bgamari/lamp/board/v1/setpoint-design.ods

Sheet: Sheet1
Vsense | V | Vout | R11 | R9 | R12
0.8 | 0 | 3.63781818181818 | 8.20E+03 | 1.00E+04 | 2.20E+03
0.8 | 0.1 | 3.55581818181818 | 2.20E+04 | 5.00E+04 | 4.70E+03
0.8 | 0.2 | 3.47381818181818 | 8.20E+03 | 1.00E+04 | 2.20E+03
0.8 | 0.3 | 3.39181818181818
0.8 | 0.4 | 3.30981818181818
0.8 | 0.5 | 3.22781818181818
0.8 | 0.6 | 3.14581818181818
0.8 | 0.7 | 3.06381818181818
0.8 | 0.8 | 2.98181818181818
0.8 | 0.9 | 2.89981818181818
0.8 | 1 | 2.81781818181818
0.8 | 1.1 | 2.73581818181818
0.8 | 1.2 | 2.65381818181818
0.8 | 1.3 | 2.57181818181818
0.8 | 1.4 | 2.48981818181818
0.8 | 1.5 | 2.40781818181818
0.8 | 1.6 | 2.32581818181818
0.8 | 1.7 | 2.24381818181818
0.8 | 1.8 | 2.16181818181818
0.8 | 1.9 | 2.07981818181818
0.8 | 2 | 1.99781818181818
0.8 | 2.1 | 1.91581818181818
0.8 | 2.2 | 1.83381818181818
0.8 | 2.3 | 1.75181818181818
0.8 | 2.4 | 1.66981818181818
0.8 | 2.5 | 1.58781818181818
0.8 | 2.6 | 1.50581818181818
0.8 | 2.7 | 1.42381818181818
0.8 | 2.8 | 1.34181818181818
0.8 | 2.9 | 1.25981818181818
0.8 | 3 | 1.17781818181818
0.8 | 3.1 | 1.09581818181818
0.8 | 3.2 | 1.01381818181818
0.8 | 3.3 | 0.931818181818182
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
