bgamari/lamp/board/v2/lamp.kicad_pcb

## KiCad design board/v2/lamp.kicad_pcb (2021-12-30)

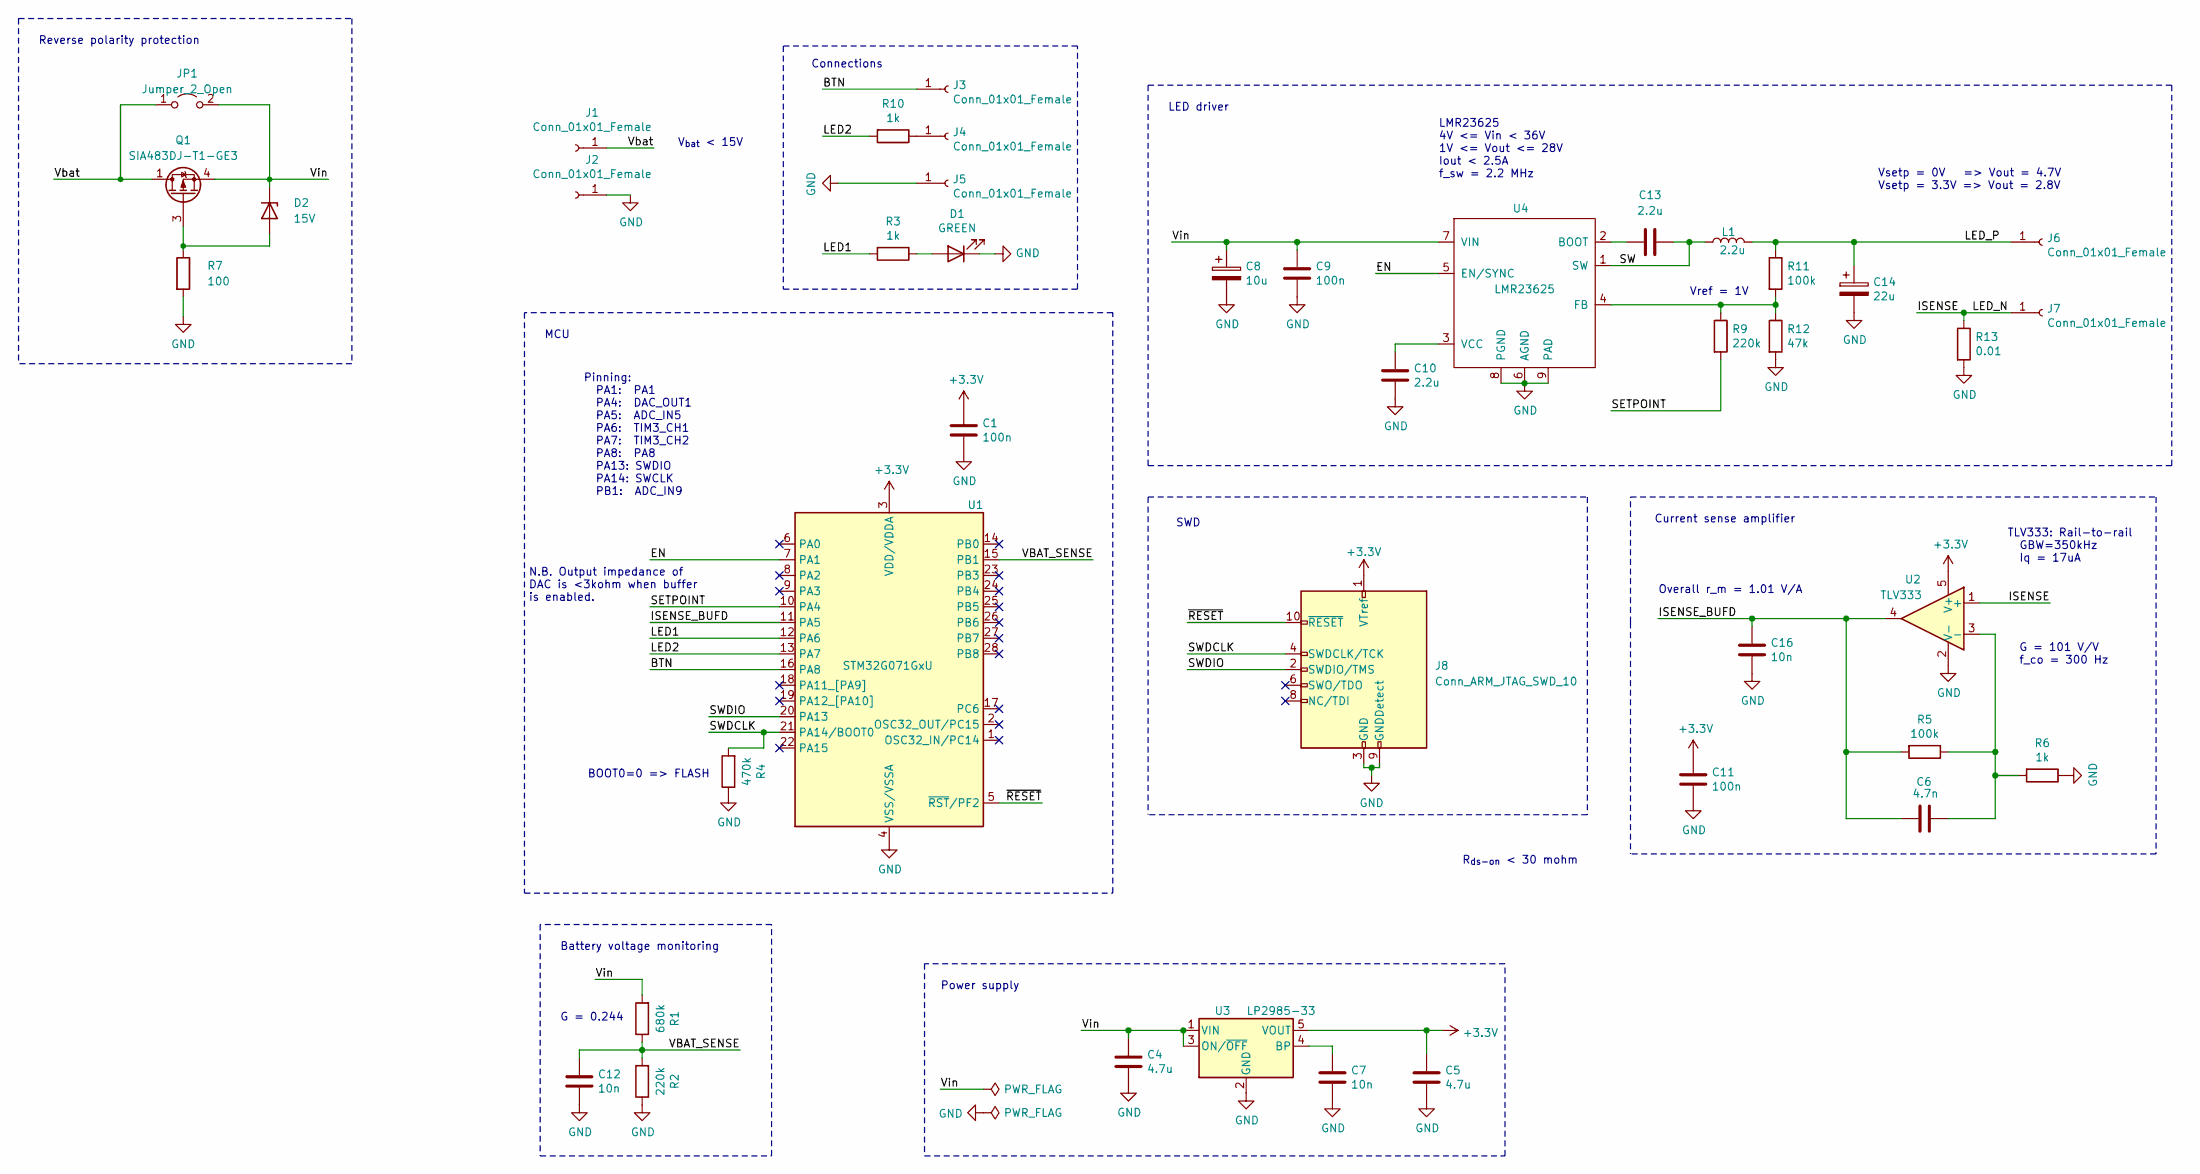
[picture p1: schematic lamp.kicad_sch, LED driver]

Parts:
C1, C9, C11: 100n; C_0603_1608Metric
C4: 4.7u; C_0805_2012Metric_Pad1.18x1.45mm_HandSolder
C5: 4.7u; C_0603_1608Metric
C6: 4.7n; C_0603_1608Metric
C7, C12, C16: 10n; C_0603_1608Metric
C8: 10u; CP_EIA-3528-12_Kemet-T; MPN T520B106M016ATE100
C10, C13: 2.2u; C_0603_1608Metric
C14: 22u; CP_EIA-7343-15_Kemet-W; MPN 25TQC22MV
D1: GREEN; LED_0603_1608Metric
D2: 15V; D_SOD-123
J1, J2, J3, J4, J5, J6, J7: Conn_01x01_Female; SolderWirePad_1x01_Drill1mm
J8: Conn_ARM_JTAG_SWD_10; PinHeader_2x05_P1.27mm_Vertical_SMD; MPN 3221-10-0300-00
JP1: Jumper_2_Open; SolderJumper-2_P1.3mm_Open_RoundedPad1.0x1.5mm
L1: 2.2u; L_7.3x7.3_H4.5; MPN DR74-2R2-R
Q1: SIA483DJ-T1-GE3‎; Vishay_PowerPAK_SC70-6L_Single; MPN SIA483DJ-T1-GE3‎
R1: 680k; R_0603_1608Metric
R2, R9: 220k; R_0603_1608Metric
R3, R6, R10: 1k; R_0603_1608Metric
R4: 470k; R_0603_1608Metric
R5, R11: 100k; R_0603_1608Metric
R7: 100; R_0603_1608Metric
R12: 47k; R_0603_1608Metric
R13: 0.01; R_0805_2012Metric; MPN RL1220T-R010-J
U1: STM32G071GxU; QFN-28_4.3x4.3_Pitch0.5mm
U2: TLV333; SOT-353_SC-70-5_Handsoldering
U3: LP2985-33; SOT-23-5; MPN LP2985-33DBVR
U4: LMR23625; SOIC-8-1EP_3.9x4.9mm_P1.27mm_EP2.29x3mm_ThermalVias; MPN TLV62130

Connections:
+3V3: C1.1, C5.1, C11.1, J8.1 (VTref), U1.3 (VDD/VDDA), U2.5 (V+), U3.5 (VOUT)
/BTN: J3.1, U1.16 (PA8)
/EN: U1.7 (PA1), U4.5 (EN/SYNC)
/ISENSE: J7.1, R13.1, U2.1 (+)
/ISENSE_BUFD: C6.2, C16.1, R5.2, U1.11 (PA5), U2.4
/LED1: R3.2, U1.12 (PA6)
/LED2: R10.2, U1.13 (PA7)
/LED_P: C14.1, J6.1, L1.2, R11.1
/SETPOINT: R9.2, U1.10 (PA4)
/SW: C13.2, L1.1, U4.1 (SW)
/SWDCLK: J8.4 (SWDCLK/TCK), R4.2, U1.21 (PA14/BOOT0)
/SWDIO: J8.2 (SWDIO/TMS), U1.20 (PA13)
/VBAT_SENSE: C12.1, R1.1, R2.2, U1.15 (PB1)
/Vbat: J1.1, JP1.1 (A), Q1.1 (D)
/Vin: C4.1, C8.1, C9.1, D2.1 (K), JP1.2 (B), Q1.4 (S), R1.2, U3.1 (VIN), U3.3 (ON/~OFF), U4.7 (VIN)
/~RESET: J8.10 (~RESET), U1.5 (~RST/PF2)
GND: C1.2, C4.2, C5.2, C7.2, C8.2, C9.2, C10.2, C11.2, C12.2, C14.2, C16.2, D1.1 (K), J2.1, J5.1, J8.3 (GND), J8.5 (GND), J8.9 (GNDDetect), R2.1, R4.1, R6.1, R7.2, R12.2, R13.2, U1.4 (VSS/VSSA), U2.2 (V-), U3.2 (GND), U4.6 (AGND), U4.8 (PGND), U4.9 (PAD)
unnamed: C6.1, R5.1, R6.2, U2.3 (-)
unnamed: C7.1, U3.4 (BP)
unnamed: C10.1, U4.3 (VCC)
unnamed: C13.1, U4.2 (BOOT)
unnamed: D1.2 (A), R3.1
unnamed: D2.2 (A), Q1.3 (G), R7.1
unnamed: J4.1, R10.1
unnamed: R9.1, R11.2, R12.1, U4.4 (FB)

Notes on the sheet:
Reverse polarity protection
N.B. Output impedance of DAC is <3kohm when buffer is enabled.
MCU
Battery voltage monitoring
G = 0.244
Pinning: PA1: PA1 PA4: DAC_OUT1 PA5: ADC_IN5 PA6: TIM3_CH1 PA7: TIM3_CH2 PA8: PA8 PA13: SWDIO PA14: SWCLK PB1: ADC_IN9
BOOT0=0 => FLASH
V_{bat} < 15V
Connections
Power supply
LED driver
SWD
LMR23625 4V <= Vin < 36V 1V <= Vout <= 28V Iout < 2.5A f_sw = 2.2 MHz
R_{ds-on} < 30 mohm
Current sense amplifier
Overall r_m = 1.01 V/A
Vref = 1V
Vsetp = 0V => Vout = 4.7V Vsetp = 3.3V => Vout = 2.8V
TLV333: Rail-to-rail GBW=350kHz Iq = 17uA
G = 101 V/V f_co = 300 Hz

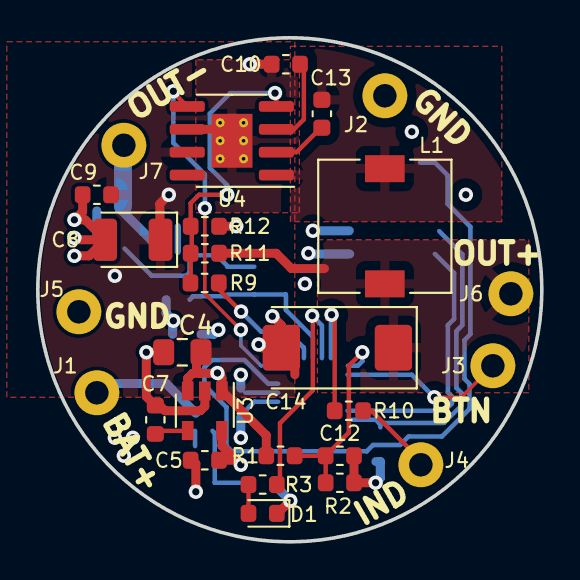
[picture p2: board board/v2/lamp.kicad_pcb from above]

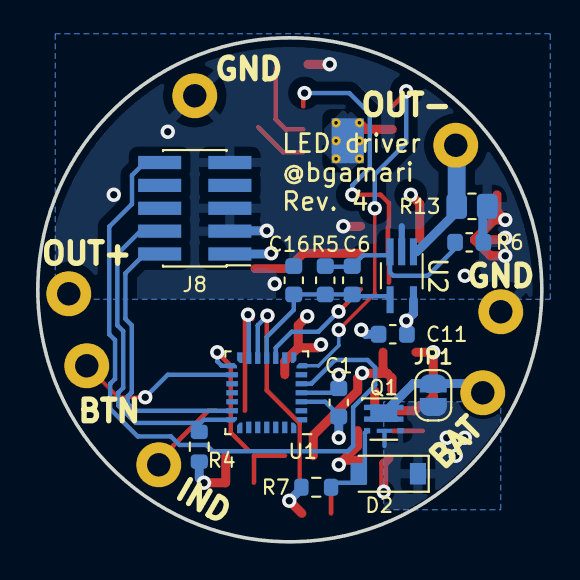
[picture p3: board board/v2/lamp.kicad_pcb from below]

Board: 4 copper layers, 28.0 x 28.0 mm, 42 parts (15 on the bottom side), 25 nets.
