bgamari/lamp/board/v1/lamp.kicad_pcb

## KiCad design board/v1/lamp.kicad_pcb (2018-07-23, an earlier design)

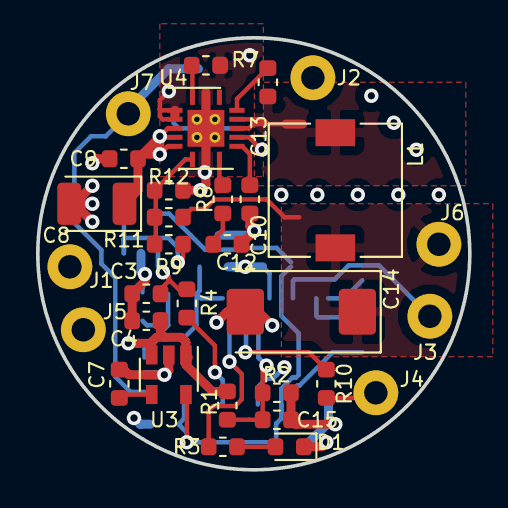
[picture p4: board board/v1/lamp.kicad_pcb from above]

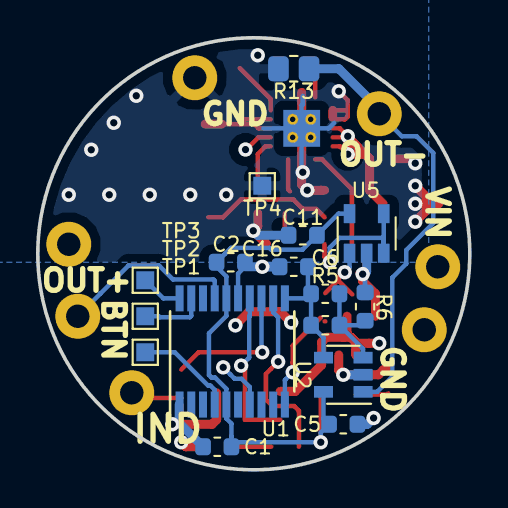
[picture p5: board board/v1/lamp.kicad_pcb from below]

Board: 4 copper layers, 24.0 x 24.0 mm, 47 parts (16 on the bottom side), 28 nets.

Parts:
C1, C2, C4, C5, C6, C7, C9, C11, C13: 100n; C_0603_1608Metric
C3: 1u; C_0603_1608Metric
C8: 10u; CP_EIA-3528-12_Kemet-T
C10, C15, C16: 10n; C_0603_1608Metric
C12: 22n; C_0603_1608Metric
C14: 47u; CP_EIA-7343-15_Kemet-W
D1: LED; LED_0603_1608Metric
J1, J2, J3, J4, J5, J6, J7: Conn_01x01_Female; SolderWirePad_1x01_Drill1mm
L1: 4.7u; L_7.3x7.3_H4.5
R1: 47k; R_0603_1608Metric
R2, R4: 10k; R_0603_1608Metric
R3, R6, R8, R10: 1k; R_0603_1608Metric
R5: 100k; R_0603_1608Metric
R7: 40k; R_0603_1608Metric
R9: 50k; R_0603_1608Metric
R11: 22k; R_0603_1608Metric
R12: 4.7k; R_0603_1608Metric
R13: 0.01; R_0805_2012Metric
TP1, TP2, TP3, TP4: Test_Point; TestPoint_Pad_1.0x1.0mm
U1: STM32F030F4P6; TSSOP-20_4.4x6.5mm_P0.65mm
U2, U5: LMV321; SOT-23-5
U3: MIC5205-3.3; SOT-23-5
U4: TPS54620; Texas_S-PVQFN-N14_ThermalVias

Connections:
+3V3: C1.1, C2.1, C5.1, C11.1, U1.5, U1.16, U2.5, U3.5, U5.5
/BTN: J3.1, U1.17
/EN: U1.7, U4.10
/ISENSE: J7.1, R13.1, U2.1
/LED1: R3.2, U1.12
/LED2: R10.2, U1.13
/LED_P: C14.1, J6.1, L1.2, R11.1
/SETPOINT: C3.1, R4.1, U5.1
/SW: C13.1, L1.1, U4.11, U4.12
/SWCLK: TP3.1, U1.20
/SWDIO: TP2.1, U1.19
/VBAT: C15.1, R1.1, R2.2, U1.14
/VIN: C4.1, C8.1, C9.1, J1.1, R1.2, U3.1, U3.3, U4.4, U4.5, U4.6
GND: C1.2, C2.2, C3.2, C4.2, C5.2, C7.2, C8.2, C9.2, C10.2, C11.2, C12.1, C14.2, C15.2, C16.2, D1.1, J2.1, J5.1, R2.1, R6.1, R7.2, R12.2, R13.2, TP4.1, U1.1, U1.15, U2.2, U3.2, U4.2, U4.3, U4.15, U5.2
unnamed: C6.1, R5.1, R6.2, U2.3
unnamed: C7.1, U3.4
unnamed: C10.1, U4.9
unnamed: C12.2, R8.2
unnamed: C13.2, U4.13
unnamed: C6.2, C16.1, R5.2, U1.11, U2.4
unnamed: D1.2, R3.1
unnamed: J4.1, R10.1
unnamed: R4.2, U1.10
unnamed: R7.1, U4.1
unnamed: R8.1, U4.8
unnamed: R9.2, U5.3, U5.4
unnamed: R9.1, R11.2, R12.1, U4.7
unnamed: TP1.1, U1.4
