bgamari/lamp/board/v1/performance.ods

Device | Vin | Iin | Vout | Iout | Pin | Pout | Efficiency | Setpoint | Comments
C | 4.85 | 0.63 | 3.42 | 0.74 | 3.0555 | 2.5308 | 82.83%
C | 5.11 | 0.146 | 2.82 | 0.23 | 0.74606 | 0.6486 | 86.94%
C | 5.07 | 0.221 | 2.94 | 0.33 | 1.12047 | 0.9702 | 86.59%
C | 5.02 | 0.314 | 3.07 | 0.422 | 1.57628 | 1.29554 | 82.19%
C | 4.96 | 0.433 | 3.2 | 0.545 | 2.14768 | 1.744 | 81.20%
C | 4.91 | 0.525 | 3.3 | 0.635 | 2.57775 | 2.0955 | 81.29%
C | 4.81 | 0.708 | 3.47 | 0.778 | 3.40548 | 2.69966 | 79.27%
C | 5.18 | 0.017 | 0.596 | 0.075 | 0.08806 | 0.0447 | 50.76% |  | No emissions
B | 5.12 | 0.165 | 2.85 | 0.26 | 0.8448 | 0.741 | 87.71%
B | 5.09 | 0.243 | 2.97 | 0.36 | 1.23687 | 1.0692 | 86.44%
B | 5.05 | 0.33 | 3.08 | 0.454 | 1.6665 | 1.39832 | 83.91%
B | 5 | 0.431 | 3.18 | 0.565 | 2.155 | 1.7967 | 83.37%
B | 4.96 | 0.53 | 3.29 | 0.664 | 2.6288 | 2.18456 | 83.10%
B | 4.91 | 0.626 | 3.38 | 0.748 | 3.07366 | 2.52824 | 82.26%
B | 4.89 | 0.69 | 3.42 | 0.803 | 3.3741 | 2.74626 | 81.39%
B | 5.19 | 0.017 | 0.586 | 0.06 | 0.08823 | 0.03516 | 39.85%
A | 5.19 | 0.016 | 0.586 | 0.048 | 0.08304 | 0.028128 | 33.87%
A | 5.07 | 0.29 | 3.06 | 0.412 | 1.4703 | 1.26072 | 85.75%
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
