bgamari/lamp/(commit log)

2018-06-30 Move to four layers, value selection
    [lamp.kicad_pcb, lamp.sch]
2018-06-30 More iteration
    [lamp.kicad_pcb, lamp.sch]
2018-06-30 Make LED PWMable
    [lamp.kicad_pcb, lamp.sch]
2018-06-30 Make other LED PWMable
    [lamp.kicad_pcb, lamp.sch]
2018-07-02 Use timers that are available on all parts
    [lamp.kicad_pcb, lamp.sch]
2018-07-22 firmware: Button support
2018-07-22 Move PWM class out to new source file
2018-07-23 More or less working
    [lamp.kicad_pcb, lamp.sch]
2019-07-03 Fix component values
    [lamp.sch]
2019-07-03 Move board design to board/v1
    [lamp.kicad_pcb, lamp.sch, performance.ods, setpoint-design.ods]
2019-07-03 v2 hardware
    [lamp.kicad_pcb, lamp.sch]
2019-07-12 hardware: Various fixes
    * Fix component values
    * Replace MIC5202 which wasn't ceramic-stable
    [lamp.kicad_pcb, lamp.sch]
2019-07-18 board/v2: Various design changes
    * Switch from MIC5202 to LP2985 due to ceramic stability issues
    with former
    * Use TLV333 for op-amps for reduced power and offset
    * Move current sense amplifier next to sense resistor
    [lamp.kicad_pcb, lamp.sch]
2019-07-18 nix: Add ARM gdb
2019-07-18 board/v2: Use two-channel op-amp
    [lamp.kicad_pcb, lamp.sch]
2019-07-22 Schematic fixes
    [lamp.sch]
2019-08-14 Hardware changes
    [lamp.kicad_pcb, lamp.sch]
2019-08-14 Reliably register button presses
    The design of stm32f0xx_hal seems antithetical to sensible use of
    interrupts so this was much harder than it should have been. In short,
    it's not possible to clear peripherals status bits in interrupt handlers
    since the library's various abstractions (e.g. `Timer`) expect to do so
    themselves. This essentially precludes use of interrupts since otherwise
    you will loop in the handler.
    [main.rs]
2019-08-14 Set reasonable default modes
    [setpoint-design.ods]
2020-08-14 Uncommitted changes
    [setpoint-design.ods]
2020-11-15 board/v2: Move to STM32L041F6P7
    This required only a small change in pinning which can be easily bodged
    onto the existing boards.
    [lamp.kicad_pcb, lamp.sch]
2021-04-19 hardware: Kicad update
    [lamp.kicad_pcb, lamp.kicad_sch, lamp.sch]
2021-04-19 hardware: Revision 3
    * Increase board size to 28mm diameter
    * Use proper 1.27 mm pin socket for debug
    * Move to STM32L051K MCU
    * Drop thermal cut-out
    [lamp.kicad_pcb, lamp.kicad_sch]
2021-05-26 board: Move to STM32G071
    [lamp.kicad_pcb, lamp.kicad_sch]
2021-05-29 hardware: Add reverse polarity protection
    [lamp.kicad_pcb, lamp.kicad_sch]
2021-05-29 hardware: More fiddling
    [lamp.kicad_pcb, lamp.kicad_sch]
2021-05-29 hardware: More wibbles
    [lamp.kicad_pcb, lamp.kicad_sch]
2021-07-29 board changes
    [lamp.kicad_pcb, lamp.kicad_sch]
2021-07-29 CAD changes
2021-07-30 board: Drop BOM
2021-07-30 board: Update kicad
    [lamp.kicad_pcb, lamp.kicad_sch]
2021-07-30 rust: Port to STM32G071
2021-07-31 Port STM32G0 firmware to embassy
2021-08-03 board: Fix footprint of op-amp
    The pinouts of the SC-70 and SOT-23-5 opamps are incompatible.
    [lamp.kicad_sch]
2021-08-05 button: await on futures
2021-08-05 button: Debug output
2021-08-30 hardware: Set R7 value
    [lamp.kicad_sch]
2021-08-30 hw: Changes
    [lamp.kicad_sch]
2021-08-31 firmware: Reasonably low power
2021-09-28 board: Add pad labels on front
    [lamp.kicad_pcb]
2021-09-28 board: Project file changes
2021-09-28 board: Set resistor value
    [lamp.kicad_sch]
2021-09-28 firmware: Add battery voltage monitoring
2021-09-28 board: Hardware fixes from assembly
    [lamp.kicad_pcb, lamp.kicad_sch]
2021-09-28 firmware: Refactor LED handling
2021-10-24 cad: Update
2021-12-29 hw: Fix RESET line on JTAG connector
    Previously this was disconnected due to a net name mismatch.
    [lamp.kicad_pcb, lamp.kicad_sch]
2021-12-29 active_state: Fix LPMS value
    [active_state.rs]
2021-12-29 firmware: Ensure that DAC is disabled until needed
    Fix an embassy bug which broke disable_channel and ensure it is called
    after startup since the channel starts in the enabled state.
    [main.rs]
2021-12-29 firmware: Don't use low-power run
    The ADC is not usable when the low-power regulator is in use (see RM0444
    section 15.3.2). Moreover, it's not necessary now that we use STOP 1
    mode.
2021-12-29 firmware: Disable ADC when not in use
    It's a bit hacky but reduces current from 20uA to 5uA.
2021-12-30 hw: Larger package for LDO input cap
    0603 was too small for a realistic capacitance.
    [lamp.kicad_pcb, lamp.kicad_sch]
2021-12-30 firmware: Teach button about active_state
